sendust/SMPTE-LTC-DECODER/LM358_MODULE.jpg

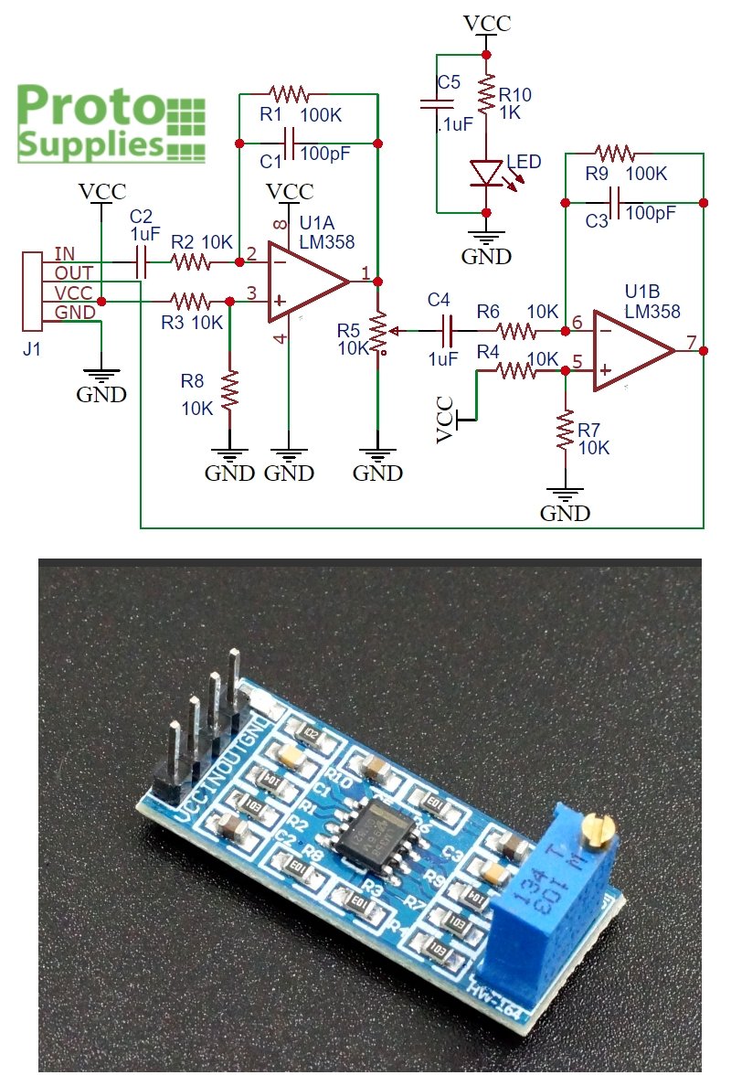
LM358_MODULE.jpg
