sendust/SMPTE-LTC-DECODER/LTC_DECODER_SCHEMATIC.pdf

# SMPTE LTC DECODER WITH TWO ARDUINO Designed by sendust 2022/2/18

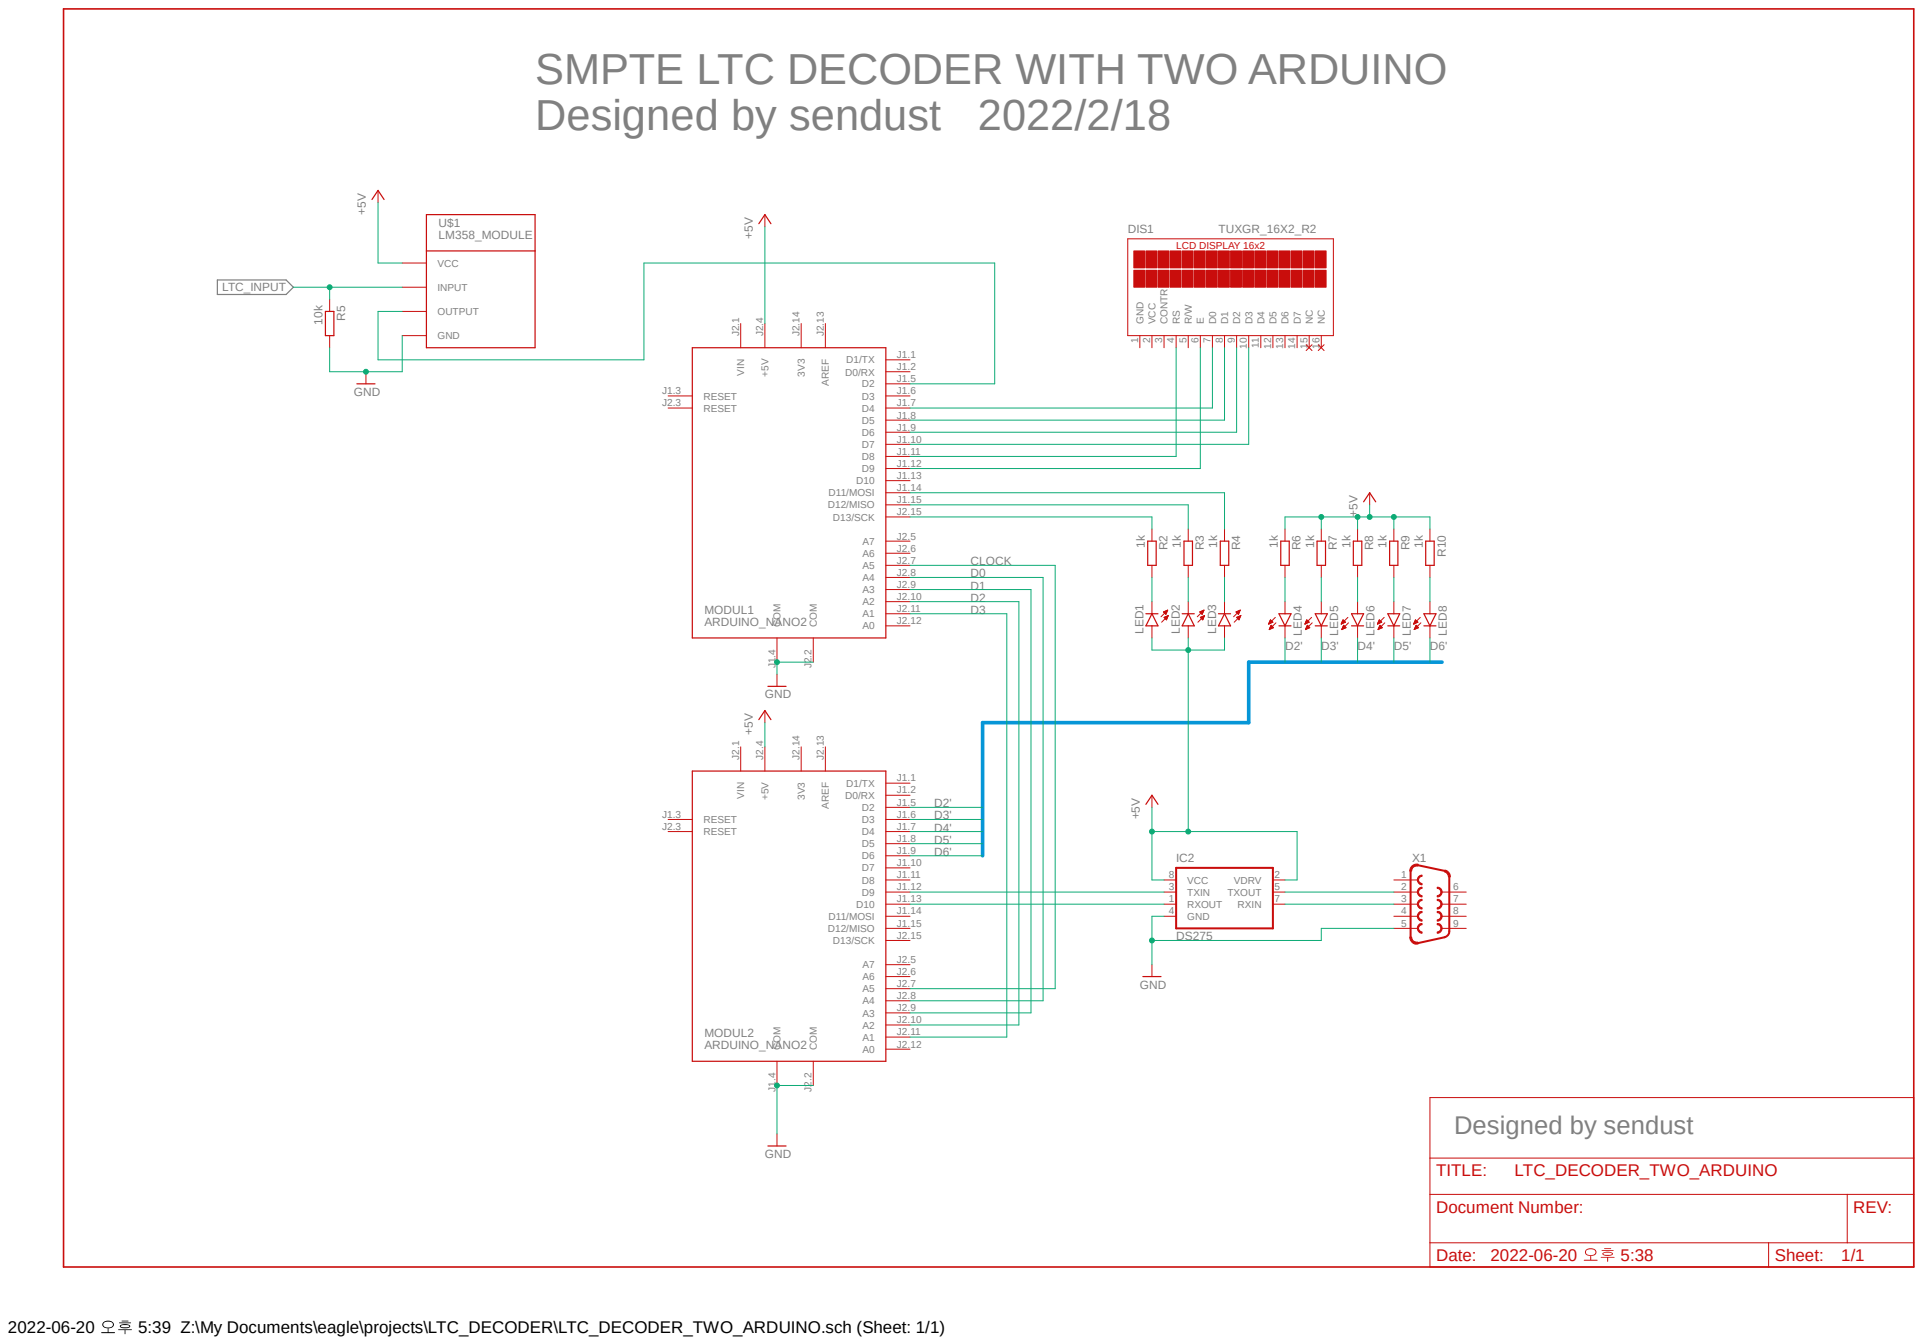
[picture p6: page 1]

Document Number: | REV:

Date: 2022-06-20 5:38 | Sheet: 1/1
