sendust/SMPTE-LTC-DECODER/(threads)

Thread 1 (2022-06-17):

Missing Values for Passive Components in ltc_Decoder_schematic.pdf

sparce-studio, 2022-06-17:
Please provide, thank you.

sendust, 2022-06-20:
Updated with new schematic.
LM358 module makes simple circuit~~

Closed 2022-06-20.
