sendust/SMPTE-LTC-DECODER/(commit log)

2022-06-20 Add files via upload
    NEW SCHEMATIC WITH ARDUINO LM358 MODULE
2026-10-17 Expand README with hardware, wiring, protocol, and firmware details
